lwh-fortune/My-First-ESP32S3/GP_26.5.8_PUB_SUB_v0.6/Readme.txt

tips：
	全新UI；
	LED、cur、fan、hum四个设备控制，
	状态栏正常显示时间、在离线
	提示音正常
	mqtt上传正常、但是 下发超时，onnnet平台控制不了单片机
	速度慢，卡顿

lib_deps =
    adafruit/Adafruit GFX Library
    adafruit/Adafruit ST7735 and ST7789 Library

这才是能下载的库
