lwh-fortune/My-First-ESP32S3/GP_26.5.11_IR_v0.7/Hardware/Previews/3D-PCB.png

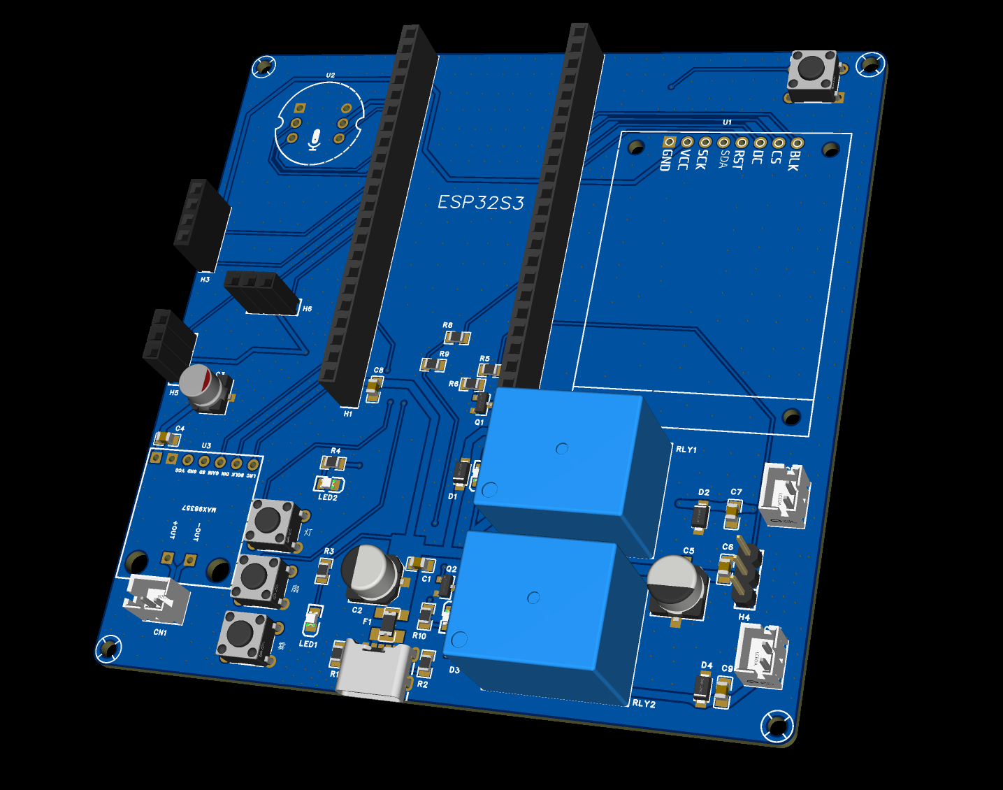
GP_26.5.11_IR_v0.7/Hardware/Previews/3D-PCB.png
