lwh-fortune/My-First-ESP32S3/GP_26.5.11_IR_v0.7/Hardware/Previews/PCB.pdf

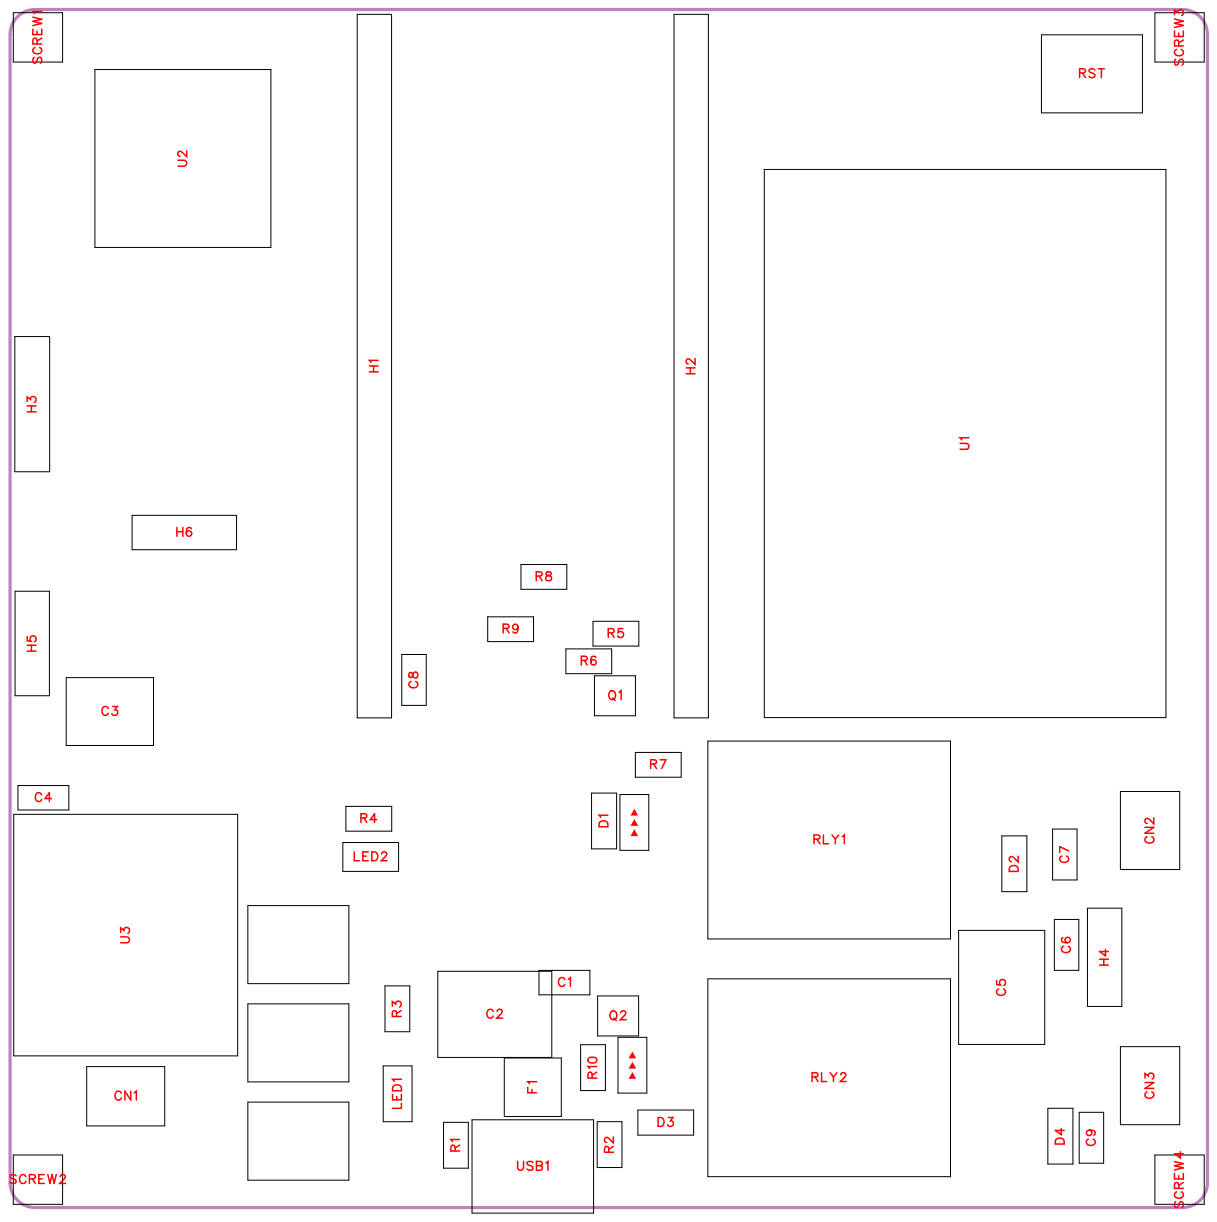
[picture p2: page 1]

No. | Quantity | Comment | Designator | Footprint | Value | Manufacturer Part | Manufacturer | Supplier Part | Supplier
1 | 6 | 0.1uf | C1,C4,C6,C7,C8,C9 | C0805 | 0.1uf | CL21B104K CFNNNE | SAMSUNG( 三星) | | LCSC
2 | 2 | 220uF | C2,C5 | CAP-SMD_B D6.3-L6.6-W 6.6-FD-1 | 220uF | JVJ16V220M 6x8 | JIERR(捷而 瑞) | C46550397 | LCSC
3 | 1 | 10uF | C3 | CAP-SMD_B D5.0-L5.3-W 5.3-LS6.0-FD | 10uF | RVT50V10M 5X5 | JIERR(捷而 瑞) | C47023118 | LCSC
4 | 3 | B2B-PH-K-S( LF)(SN) | CN1,CN2,CN3 | CONN-TH_B 2B-PH-K-S | | B2B-PH-K-S( LF)(SN) | JST | C131337 | LCSC
5 | 4 | 1N4007W | D1,D2,D3,D4 | SOD-123FL_ L2.7-W1.8-L S3.8-RD | | 1N4007W | R+O(宏嘉诚) | C18199088 | LCSC
6 | 1 | BSMD1206C -1400T | F1 | F1206 | | BSMD1206C -1400T | BHFUSE(佰 宏) | C41367227 | LCSC
7 | 2 | ZX-PM2.54-1 -22PY | H1,H2 | HDR-TH_22 P-P2.54-V-F | | ZX-PM2.54-1 -22PY | Megastar(兆 星) | C7499337 | LCSC
8 | 1 | HDR-F_2.54 _1x4P | H3 | HDR-TH_4P-P2.54-V-F | | | | C2718488
9 | 1 | HDR-M_2.54 _1x3P | H4 | HDR-TH_3P-P2.54-V-M | | | | C2937625
10 | 2 | HDR-F_2.54 _1x3P | H5,H6 | HDR-TH_3P-P2.54-V-F | | | | C541850
11 | 4 | GL0805UR0 1 | LED1,LED2,扇>>>,雾>>> | LED0805-R-RD_RED | | GL0805UR0 1 | Guiguang lig ht(桂光光电) | C51933307 | LCSC
12 | 1 | SS8050 | Q1 | SOT-23-3_L2 .9-W1.3-P1.9 0-LS2.4-BR | | SS8050 | R+O(宏嘉诚) | C7420370 | LCSC
13 | 1 | S8050(0.5A) | Q2 | SOT-23-3_L2 .9-W1.3-P1.9 0-LS2.4-BR | | S8050(0.5A) | EIC | C3014350 | LCSC
14 | 2 | 5.1k | R1,R2 | R0805 | 5.1k | 0805W8F510 1T5E | UNI-ROYAL( 厚声) | C27834 | LCSC
15 | 1 | 470 | R3 | R0805 | 470 | 0805W8F470 0T5E | UNI-ROYAL( 厚声) | C17710 | LCSC
16 | 1 | 220 | R4 | R0805 | 220 | 0805W8F220 0T5E | UNI-ROYAL( 厚声) | C17557 | LCSC
17 | 2 | 4.7k | R5,R8 | R0805 | 4.7k | RC0805FR-0 71KL | YAGEO(国巨 ) | | LCSC
18 | 2 | 5.1k | R6,R9 | R0805 | 5.1k | 0805W8F100 2T5E | UNI-ROYAL( 厚声) | | LCSC
19 | 2 | 470 | R7,R10 | R0805 | 470 | 0805W8F100 2T5E | UNI-ROYAL( 厚声) | | LCSC
20 | 2 | SRD-05VDC-SL-C | RLY1,RLY2 | RELAY-TH_ SRD-XXVDC -XL-C | | SRD-05VDC-SL-C | 松乐 | C35449 | LCSC

21 | 4 | SH-6X6X4.3 H-CJ | RST, 扇 , 灯 , 雾 | SW-TH_SH-6X6X4.3H-C J | SH-6X6X4.3 H-CJ | SHOU HAN(首韩 ) | C42416242 | LCSC
22 | 4 | M2螺丝 | SCREW1,SCREW2,SCRE W3,SCREW4 | M2螺丝
23 | 1 | 1.54 寸240*2 40LCD | U1 | 1.54 寸LCD
24 | 1 | 带排针INMP4 41 | U2 | 全向麦克风模 块INMP441
25 | 1 | 接 8 2W小喇 叭 | U3 | MAX98357 模 块
26 | 1 | TYPE-C 6P | USB1 | TYPE-C-SM D_TYPE-C-6 P_1 | TYPE-C 6P | SHOU HAN(首韩 ) | C456012 | LCSC

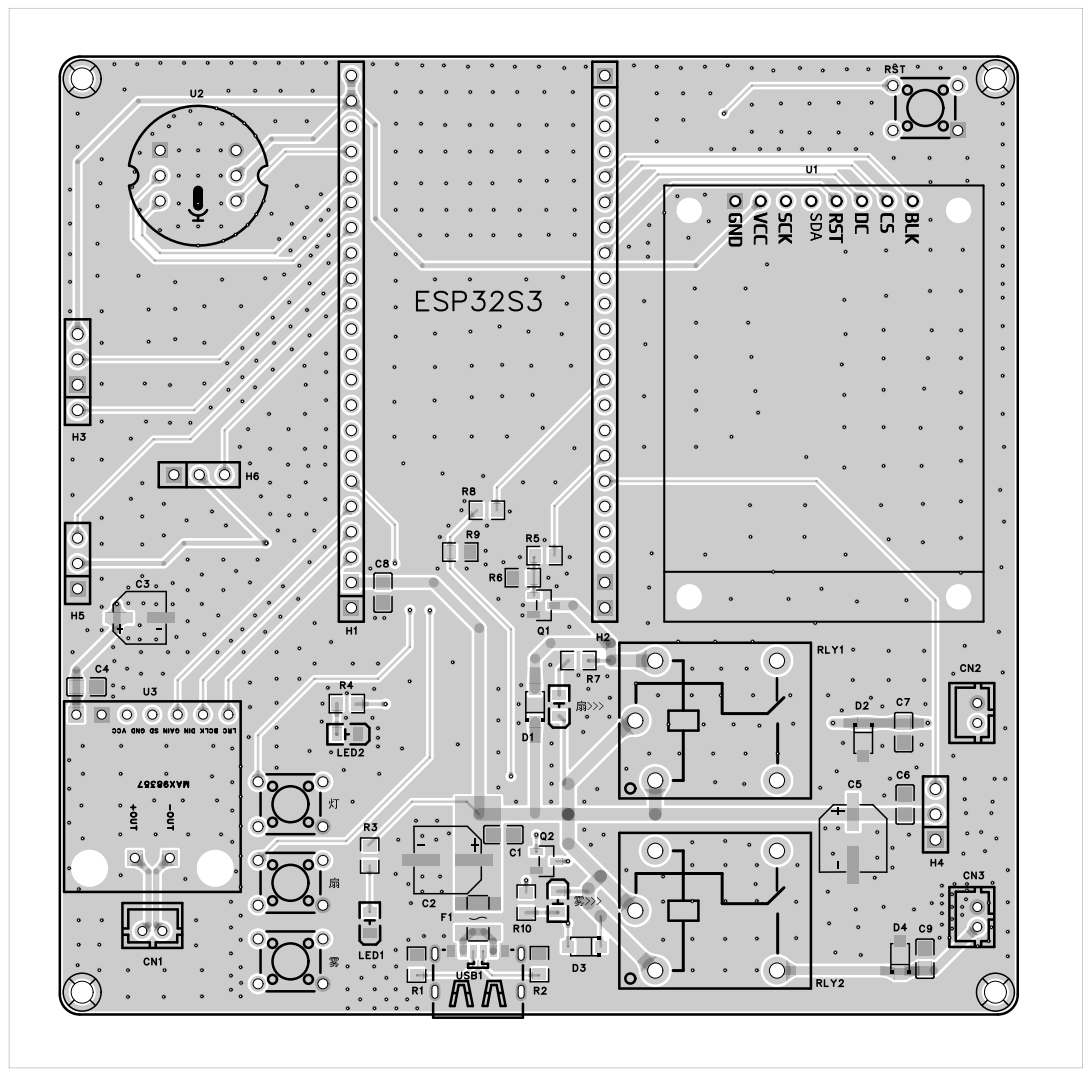
[picture p3: page 5]

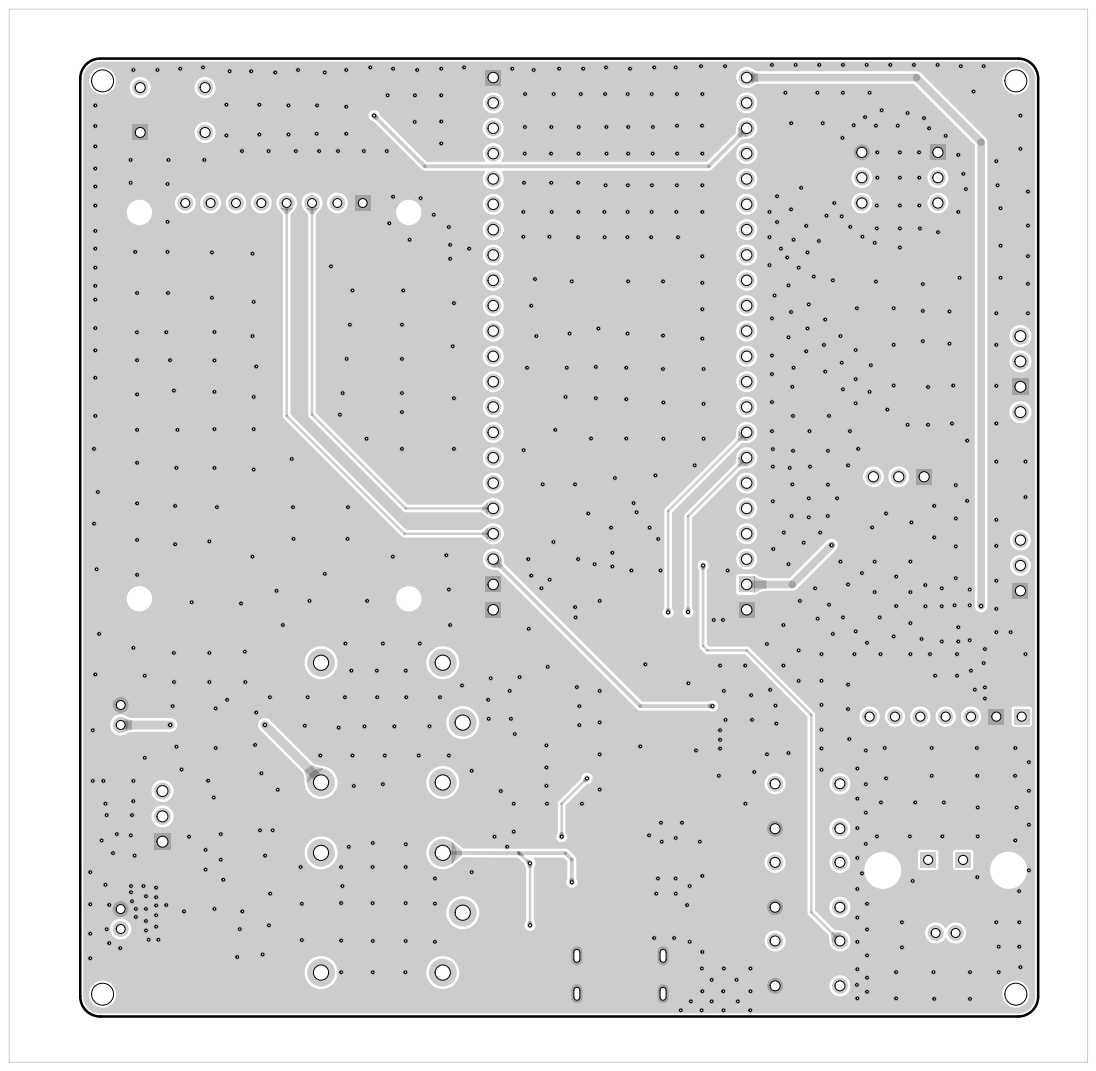
[picture p4: page 6]

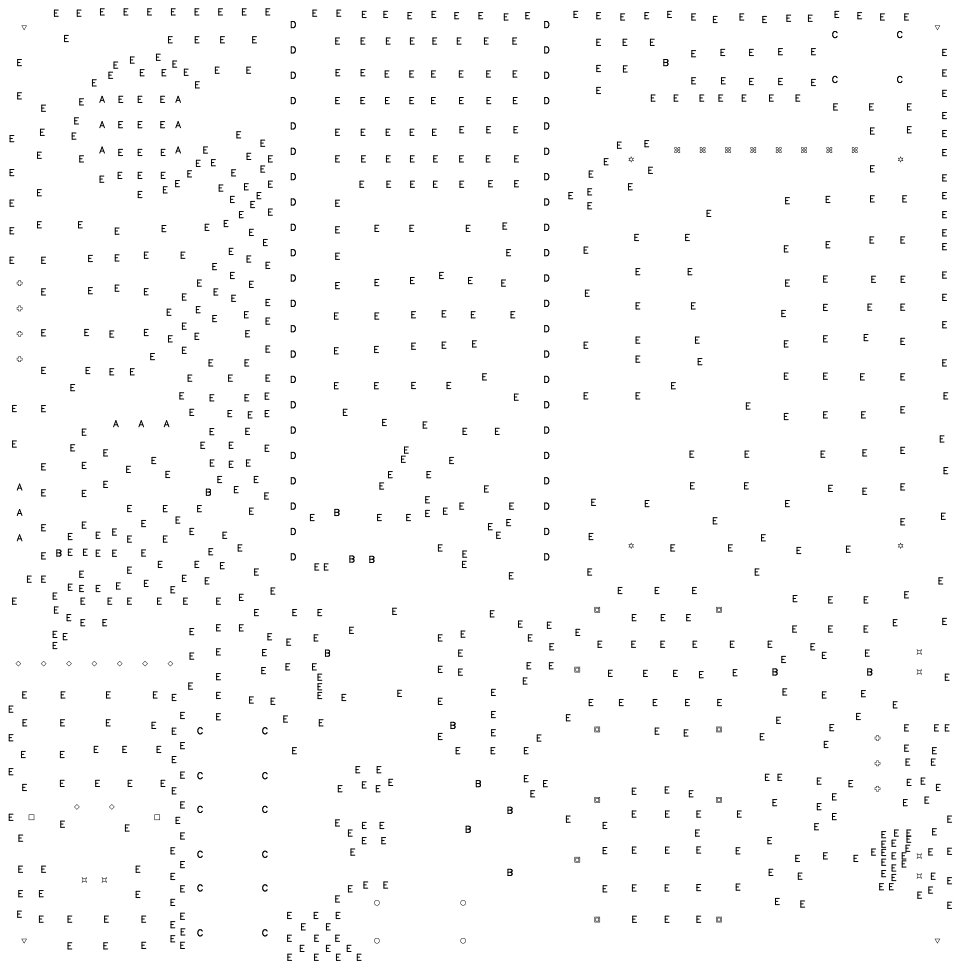
[picture p5: page 7]
