lwh-fortune/My-First-ESP32S3/(commit log)

2026-06-20 上传ESP32S3完整工程源码
    [my_16MB_spiffs.csv]
2026-06-20 esp32家居系统
    [my_16MB_spiffs.csv]
